HoGC/Gizwits_Fingerprint_Lock/3D打印/D1_Lock_1(R).SLDPRT

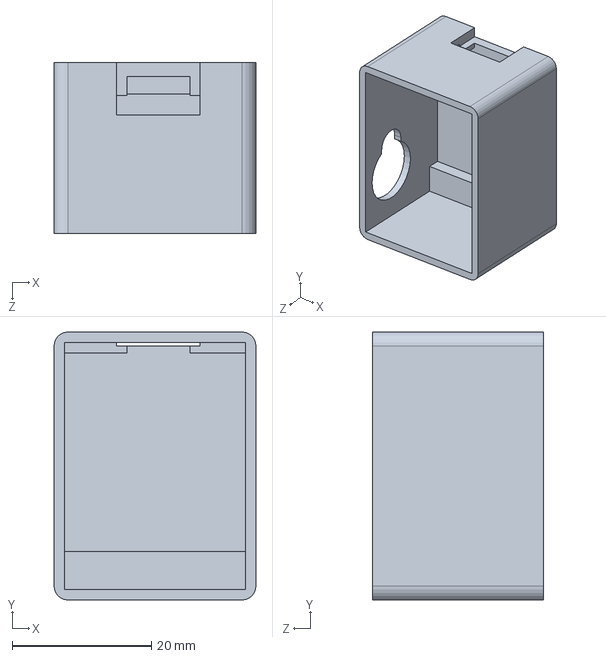
[picture p8: CAD file, 2019-12-05]
3D打印/D1_Lock_1(R).SLDPRT
29.0 x 38.5 x 24.5 mm
