HoGC/Gizwits_Fingerprint_Lock/3D打印/D1_Lock_2.SLDPRT

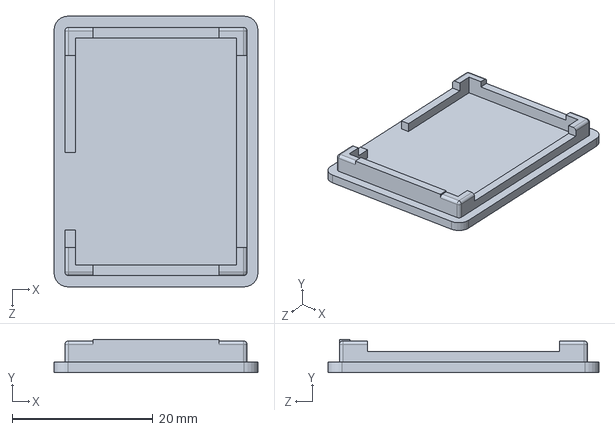
[picture p9: CAD file, 2019-12-05]
3D打印/D1_Lock_2.SLDPRT
29.0 x 4.70 x 38.5 mm
