HoGC/Gizwits_Fingerprint_Lock/(list of files, cad)

Other CAD files:
3D打印/D1_Lock_1(L).SLDPRT
3D打印/D1_Lock_1(L).STL
3D打印/D1_Lock_2.STL
