HoGC/Gizwits_Fingerprint_Lock/Gizwits_Fingerprint_Lock/app/Gizwits/gizwits_product.c

/**
************************************************************
* @file         gizwits_product.c
* @brief        Control protocol processing, and platform-related hardware initialization
* @author       Gizwits
* @date         2017-07-19
* @version      V03030000
* @copyright    Gizwits
*
* @note         机智云.只为智能硬件而生
*               Gizwits Smart Cloud  for Smart Products
*               链接|增值ֵ|开放|中立|安全|自有|自由|生态
*               www.gizwits.com
*
***********************************************************/
#include <stdio.h>
#include <string.h>
#include "gizwits_product.h"
#include "driver/gpio_key.h"
#include "driver/lock.h"
/** User area The current device state structure */
dataPoint_t currentDataPoint;

/**
* @brief Event handling interface

* Description:

* 1. Users can customize the changes in WiFi module status

* 2. Users can add data points in the function of event processing logic, such as calling the relevant hardware peripherals operating interface

* @param [in] info: event queue
* @param [in] data: protocol data
* @param [in] len: protocol data length
* @return NULL
* @ref gizwits_protocol.h
*/
int8_t ICACHE_FLASH_ATTR gizwitsEventProcess(eventInfo_t *info, uint8_t *data, uint32_t len)
{
    uint8_t i = 0;
    dataPoint_t * dataPointPtr = (dataPoint_t *)data;
    moduleStatusInfo_t * wifiData = (moduleStatusInfo_t *)data;

    if((NULL == info) || (NULL == data))
    {
        GIZWITS_LOG("!!! gizwitsEventProcess Error \n");
        return -1;
    }

    for(i = 0; i < info->num; i++)
    {
        switch(info->event[i])
        {
        case EVENT_lock :
            currentDataPoint.valuelock = dataPointPtr->valuelock;
            GIZWITS_LOG("Evt: EVENT_lock %d \n", currentDataPoint.valuelock);
            if(0x01 == currentDataPoint.valuelock)
            {
                lock_open();
            }else{
                lock_close();
            }
            break;

        case WIFI_SOFTAP:
            break;
        case WIFI_AIRLINK:
            break;
        case WIFI_STATION:
            break;
        case WIFI_CON_ROUTER:
            GIZWITS_LOG("@@@@ connected router\n");
 
            break;
        case WIFI_DISCON_ROUTER:
            GIZWITS_LOG("@@@@ disconnected router\n");
 
            break;
        case WIFI_CON_M2M:
            GIZWITS_LOG("@@@@ connected m2m\n");
			setConnectM2MStatus(0x01);
 
            break;
        case WIFI_DISCON_M2M:
            GIZWITS_LOG("@@@@ disconnected m2m\n");
			setConnectM2MStatus(0x00);
 
            break;
        case WIFI_RSSI:
            GIZWITS_LOG("@@@@ RSSI %d\n", wifiData->rssi);
            break;
        case TRANSPARENT_DATA:
            GIZWITS_LOG("TRANSPARENT_DATA \n");
            //user handle , Fetch data from [data] , size is [len]
            
            //数据透传
            switch (data[0])
            {
                //指纹
                case 0xBA:
                    //注册指纹
                    if(data[1]== 0x02){
                        fp_register();
                    //删除指纹
                    }else if(data[1]== 0x03){
                        fp_delete(data[2]);
                    }
                    break;
#if PWM_LOCK
                //舵机角度设置
                case 0xAA:
                    set_angle_min(data[1]);
                    set_angle_max(data[2]);
                    lock_open();
                    break;
                //舵机打开时间设置
                case 0xAB:
                    if(data[1] > 0x10)
                        data[1]=data[1]-6;
                    set_open_time(data[1]);
                    break;
#endif            
                default:
                    break;
                }

            break;
        case MODULE_INFO:
            GIZWITS_LOG("MODULE INFO ...\n");
            break;
            
        default:
            break;
        }
    }
    system_os_post(USER_TASK_PRIO_2, SIG_UPGRADE_DATA, 0);
    
    return 0; 
}


/**
* User data acquisition

* Here users need to achieve in addition to data points other than the collection of data collection, can be self-defined acquisition frequency and design data filtering algorithm

* @param none
* @return none
*/
void ICACHE_FLASH_ATTR userHandle(void)
{
    /*

    */
	 
    system_os_post(USER_TASK_PRIO_2, SIG_UPGRADE_DATA, 0);
}


/**
* Data point initialization function

* In the function to complete the initial user-related data
* @param none
* @return none
* @note The developer can add a data point state initialization value within this function
*/
void ICACHE_FLASH_ATTR userInit(void)
{
    gizMemset((uint8_t *)&currentDataPoint, 0, sizeof(dataPoint_t));

 	/** Warning !!! DataPoint Variables Init , Must Within The Data Range **/ 
    /*
   		currentDataPoint.valuelock = ;
    */
}
