HoGC/Gizwits_Fingerprint_Lock/(commit log)

2019-11-22 ESP8266指纹门锁
    [指纹锁.xlsx]
2019-12-05 更新README.md
    [D1_Lock_1(L).SLDPRT, D1_Lock_1(L).STL, D1_Lock_1(R).SLDPRT, D1_Lock_2.SLDPRT, D1_Lock_2.STL]
